rcyaon/CMOS_LNB/README.md

# GF180MCU L-Band LNB

MIT License

Copyright 2026 Charlie Sands & Lena Conde Araujo

## Overview

This is an integrated L-band block downconverter IC including a low-noise amplifier, downconverting mixer, and oscillator. This IP block, designed for broadband operation between approximately 300 MHz and 2 GHz, will allow for downconversion of interesting signals in the UHF, L, and S band spectra. An integrated oscillator will provide a toggleable L-band local oscillator signal to the mixer, allowing for standalone operation of the circuit as an integrated low-noise block (LNB) for applications such as reception of GOES weather satellite HRIT transmissions, GPS, and amateur radio (23 cm band).

Targeting a tapeout using Wafer.Space on GF180MCU through the Chipalooza Challenge #3.
