rcyaon/CMOS_LNB/Schematics #2/sims/area/netlists/beta_mult.spice

** sch_path: /foss/designs/Designs/bias-other/xschem/beta_mult.sch
**.subckt beta_mult vdd pg ng ns cpret s1 kg
*.iopin vdd
*.iopin pg
*.iopin ng
*.iopin ns
*.iopin cpret
*.iopin s1
*.iopin kg
XC1 ng gnd cap_mim_2f0fF c_width=22u c_length=22u
XR1 ns net1 gnd ppolyf_u_1k r_width=2u r_length=rp_l
XM1 gnd ng ng GND nfet_06v0 L=2u W=20u nf=1 ad='int((nf+1)/2) * W/nf * 0.18u' as='int((nf+2)/2) * W/nf * 0.18u' pd='2*int((nf+1)/2) * (W/nf + 0.18u)'
+ ps='2*int((nf+2)/2) * (W/nf + 0.18u)' nrd='0.18u / W' nrs='0.18u / W' sa=0 sb=0 sd=0
XM2 gnd ng s1 GND nfet_06v0 L=1u W=10u nf=1 ad='int((nf+1)/2) * W/nf * 0.18u' as='int((nf+2)/2) * W/nf * 0.18u' pd='2*int((nf+1)/2) * (W/nf + 0.18u)'
+ ps='2*int((nf+2)/2) * (W/nf + 0.18u)' nrd='0.18u / W' nrs='0.18u / W' sa=0 sb=0 sd=0
XM3 gnd kg pg GND nfet_06v0 L=1u W=2u nf=1 ad='int((nf+1)/2) * W/nf * 0.18u' as='int((nf+2)/2) * W/nf * 0.18u' pd='2*int((nf+1)/2) * (W/nf + 0.18u)'
+ ps='2*int((nf+2)/2) * (W/nf + 0.18u)' nrd='0.18u / W' nrs='0.18u / W' sa=0 sb=0 sd=0
XM5 s1 gnd vdd VDD pfet_06v0 L=50u W=0.5u nf=1 ad='int((nf+1)/2) * W/nf * 0.18u' as='int((nf+2)/2) * W/nf * 0.18u' pd='2*int((nf+1)/2) * (W/nf + 0.18u)'
+ ps='2*int((nf+2)/2) * (W/nf + 0.18u)' nrd='0.18u / W' nrs='0.18u / W' sa=0 sb=0 sd=0
XM6 vdd pg ng VDD pfet_06v0 L=2u W=40u nf=1 ad='int((nf+1)/2) * W/nf * 0.18u' as='int((nf+2)/2) * W/nf * 0.18u' pd='2*int((nf+1)/2) * (W/nf + 0.18u)'
+ ps='2*int((nf+2)/2) * (W/nf + 0.18u)' nrd='0.18u / W' nrs='0.18u / W' sa=0 sb=0 sd=0
XC2 pg cpret cap_mim_2f0fF c_width=22u c_length=22u
XM7 pg ng ns GND nfet_06v0 L=2u W=80u nf=1 ad='int((nf+1)/2) * W/nf * 0.18u' as='int((nf+2)/2) * W/nf * 0.18u' pd='2*int((nf+1)/2) * (W/nf + 0.18u)'
+ ps='2*int((nf+2)/2) * (W/nf + 0.18u)' nrd='0.18u / W' nrs='0.18u / W' sa=0 sb=0 sd=0
XM4 pg pg vdd VDD pfet_06v0 L=2u W=40u nf=1 ad='int((nf+1)/2) * W/nf * 0.18u' as='int((nf+2)/2) * W/nf * 0.18u' pd='2*int((nf+1)/2) * (W/nf + 0.18u)'
+ ps='2*int((nf+2)/2) * (W/nf + 0.18u)' nrd='0.18u / W' nrs='0.18u / W' sa=0 sb=0 sd=0
XR2 net1 gnd gnd nwell r_width=2u r_length=rn_l
**** begin user architecture code

.param rp_l=2.7u rn_l=4.07u

**** end user architecture code
**.ends
.end
