rcyaon/CMOS_LNB/(commit log)

2026-09-11 First commit, adding initial versions of the impedance matching network, LNA and balun
    [AmpCore.sch, AmpCore_Testing.sch, Balun.sch, DiffPairBalun.sch, ImpedanceMatching.sch, System.sch]
2026-09-11 Changed file organization structure
    [AmpCore.sch, AmpCore_Testing.sch, Balun.sch, DiffPairBalun.sch, ImpedanceMatching.sch, System.sch]
2026-09-14 redesigned the balun and added the gilbert cell to the circuit
    [AmpCore.sch, Balun_Testing.sch, DiffPairBalun.sch, GilbertCell.sch, GilbertCell_Testing.sch, System.sch]
2026-09-14 cleaned up some floating elements
    [DiffPairBalun.sch, System.sch]
2026-09-14 more clean up
    [System.sch]
2026-09-20 Reworked active balun to have much better common mode balancing.
    [AmpCore.sch, Balun_Testing.sch, Balun_Testing_MkII.sch, DiffPairBalun.sch, GilbertCell.sch, GilbertCell_Testing.sch, ImpedanceMatching.sch, LNA_System.sch]
2026-09-22 adding my schs
    [beta_mult.sch, dstage.sch, inv.sch, ota5.sch, ringosci.sch, vref.sch]
2026-09-25 added changes to testing and oscillator
    [AmpCore.sch, GilbertCell.sch, ImpedanceMatching.sch, LNA_OIP3.sch, LNA_S_Parameters.sch, LNA_SingleStage.sch, LNA_System.sch, LNA_VoltageGain.sch]
2026-09-26 qucs addition
    [beta_mult.sch, inv.sch, inv_cs.sch, ota5.sch, ringosci.sch, tb_beta_mult_startup.sch, tb_beta_mult_supply.sch, tb_beta_mult_temp.sch]
